mint-n-pepper/dancebots_electronics/(commit log)

2017-09-12 V1 of the Attiny861 programming interface board
    [Attiny861-ProgrammingBRD.kicad_pcb, Attiny861-ProgrammingBRD.sch]
2017-09-12 fixed footprint ref in schematic
    [Attiny861-ProgrammingBRD.sch]
2017-09-17 first draft of schematic
    [dancebots-pcb.sch]
2017-09-20 version 7.0 sent off for prototyping
    [dancebots-pcb.kicad_pcb, dancebots-pcb.sch]
2017-10-01 changed fp slightly after first iteration
    [dancebots-pcb.kicad_pcb]
2017-10-13 shrunk CAP holes to 0.8mm
    [dancebots-pcb.kicad_pcb]
2018-02-02 added gerber files
    [dancebots-pcb-B.Cu.gbr, dancebots-pcb-B.Mask.gbr, dancebots-pcb-B.SilkS.gbr, dancebots-pcb-Dwgs.User.gbr, dancebots-pcb-Edge.Cuts.gbr, dancebots-pcb-F.Cu.gbr, dancebots-pcb-F.Mask.gbr, dancebots-pcb-F.SilkS.gbr]
2018-02-02 added programming board lib table
2018-02-02 added programming board gerber files
    [Attiny861-ProgrammingBRD-B.Cu.gbr, Attiny861-ProgrammingBRD-B.Mask.gbr, Attiny861-ProgrammingBRD-B.SilkS.gbr, Attiny861-ProgrammingBRD-Dwgs.User.gbr, Attiny861-ProgrammingBRD-Edge.Cuts.gbr, Attiny861-ProgrammingBRD-F.Cu.gbr, Attiny861-ProgrammingBRD-F.Mask.gbr, Attiny861-ProgrammingBRD-F.SilkS.gbr]
2018-02-02 added readme and usb socket datasheet
2018-04-26 shrunk motor and speaker pads to reduce bridge soldering risk
    [dancebots-pcb.kicad_pcb]
2018-04-26 fixed silkscreen text to 2018 and 7.1
    [dancebots-pcb.kicad_pcb]
2018-04-26 added ordered gerber files in gerberv7.1.zip
2018-04-27 removed dwgs layer from zip archive as it confuses the gerber viewer / processing at jlcpcb
2018-05-09 fixed broken ground plane connector near SPKR
    [dancebots-pcb.kicad_pcb]
2019-09-26 added solder exercise PCB draft
    [solder-ex-pcb.kicad_pcb, solder-ex-pcb.sch]
2019-10-09 added tester to solder exercise pcb
    [solder-ex-pcb.kicad_pcb, solder-ex-pcb.sch]
2019-10-15 ordered version of the solder exercise pcb
    [solder-ex-pcb.kicad_pcb]
2019-12-16 v7.2: fixed symbol and library references, added part numbers, and cleaned up gnd vias on PCB
    [dancebots-pcb-B_Cu.gbr, dancebots-pcb-B_Mask.gbr, dancebots-pcb-B_SilkS.gbr, dancebots-pcb-Dwgs_User.gbr, dancebots-pcb-Edge_Cuts.gbr, dancebots-pcb-F_Cu.gbr, dancebots-pcb-F_Mask.gbr, dancebots-pcb-F_SilkS.gbr]
2019-12-17 updated readme and added CERN license (also to PCB silkscreen)
    [dancebots-pcb-B_Cu.gbr, dancebots-pcb-B_Mask.gbr, dancebots-pcb-B_SilkS.gbr, dancebots-pcb-Dwgs_User.gbr, dancebots-pcb-Edge_Cuts.gbr, dancebots-pcb-F_Cu.gbr, dancebots-pcb-F_Mask.gbr, dancebots-pcb-F_SilkS.gbr]
2020-05-28 Hofmannp/fix projects for261 (#1)
    * fixed project files for 861 and 261 versions and production file
    * fixed production files for reals
    [MP3DanceBot.c]
2022-09-13 migrated to Kicad 6.0
    [dancebots-pcb.kicad_pcb, dancebots-pcb.kicad_sch, dancebots-pcb.sch]
2022-09-14 V8.0, MP3 Player integrated
    [dancebots-pcb-B.Cu.gbr, dancebots-pcb-B.Mask.gbr, dancebots-pcb-B.SilkS.gbr, dancebots-pcb-B_Cu.gbr, dancebots-pcb-B_Mask.gbr, dancebots-pcb-B_SilkS.gbr, dancebots-pcb-Dwgs.User.gbr, dancebots-pcb-Dwgs_User.gbr]
2022-09-15 Update dancebots-pcb.kicad_sch
    Optimized resistor values.
    [dancebots-pcb.kicad_sch]
2022-09-15 Update dancebots-pcb.kicad_sch
    Updated Title Block
    [dancebots-pcb.kicad_sch]
2022-09-28 V8.1: Changed DFplayer Mini to oblong holes for beveled headers
    [dancebots-pcb.kicad_pcb, dancebots-pcb.kicad_sch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]
2022-10-27 Version 8.2
    Version 8.2
    Changes on Silkscreen, polarity signs for LED, simple orientiation help for df-player. 33k instead of 20k for easier colour code Identification.
    [dancebots-pcb.kicad_pcb, dancebots-pcb.kicad_sch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]
2022-11-14 Minor change: Version on Silkscreen
    [dancebots-pcb.kicad_pcb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]
2025-02-26 updated mcu to attiny861 in schematic and pcb; migrated to kicad v7
    [dancebots-pcb.kicad_pcb, dancebots-pcb.kicad_sch]
2025-03-19 added gerbers and drill files for v8.3
    [dancebots-pcb-B_Cu.gbl, dancebots-pcb-B_Cu.gbr, dancebots-pcb-B_Mask.gbr, dancebots-pcb-B_Mask.gbs, dancebots-pcb-B_Silkscreen.gbo, dancebots-pcb-Edge_Cuts.gbr, dancebots-pcb-Edge_Cuts.gm1, dancebots-pcb-F_Cu.gbr]
