mint-n-pepper/dancebots_electronics/(notices)

Notices in the files:
DancebotsFirmware/src/MP3DanceBot.c:
under the terms of the GNU General Public License as published by the Free
